husinthewei/PMTPulser/OPics/IMG_4144.JPG

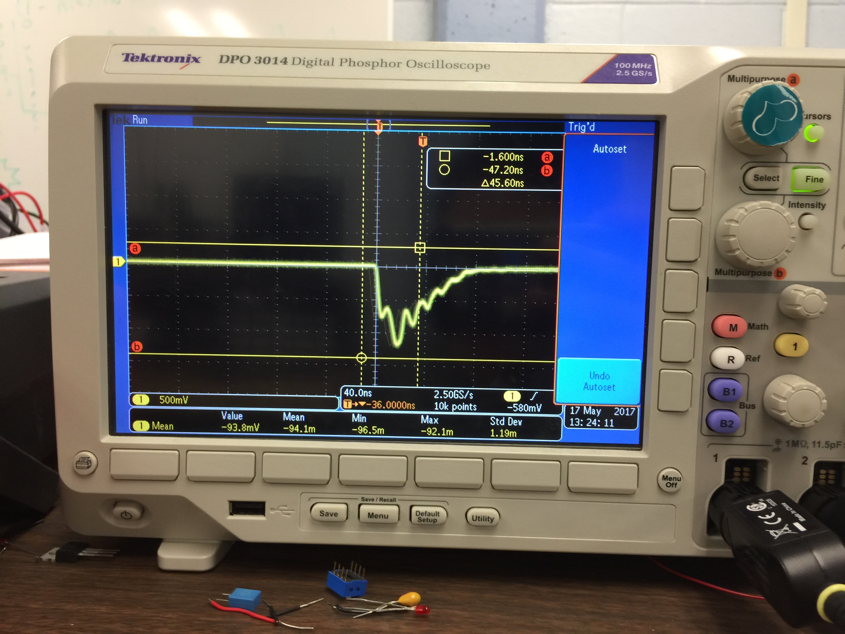
OPics/IMG_4144.JPG
