husinthewei/PMTPulser/OPics/IMG_4136.JPG

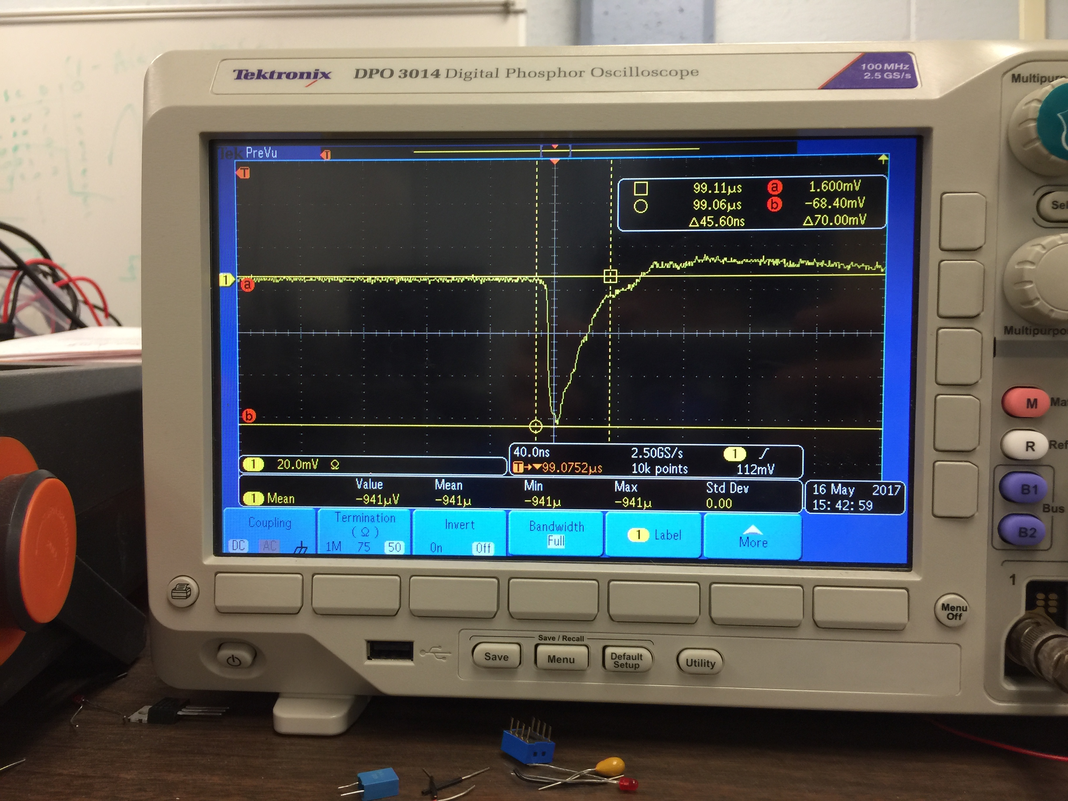
OPics/IMG_4136.JPG
