husinthewei/PMTPulser/README.md

# PMTPulser

A PCB used to emulate photomultiplier tube signals. Pulses have ~500mV amplitude and ~300ns rise time.
