husinthewei/PMTPulser/ltspice/APDAmp/APD_Amp.pptx

## Low Input Impedance APD amp

Mitch Newcomer
Penn
24 June 2013

## APD Amp Schematic

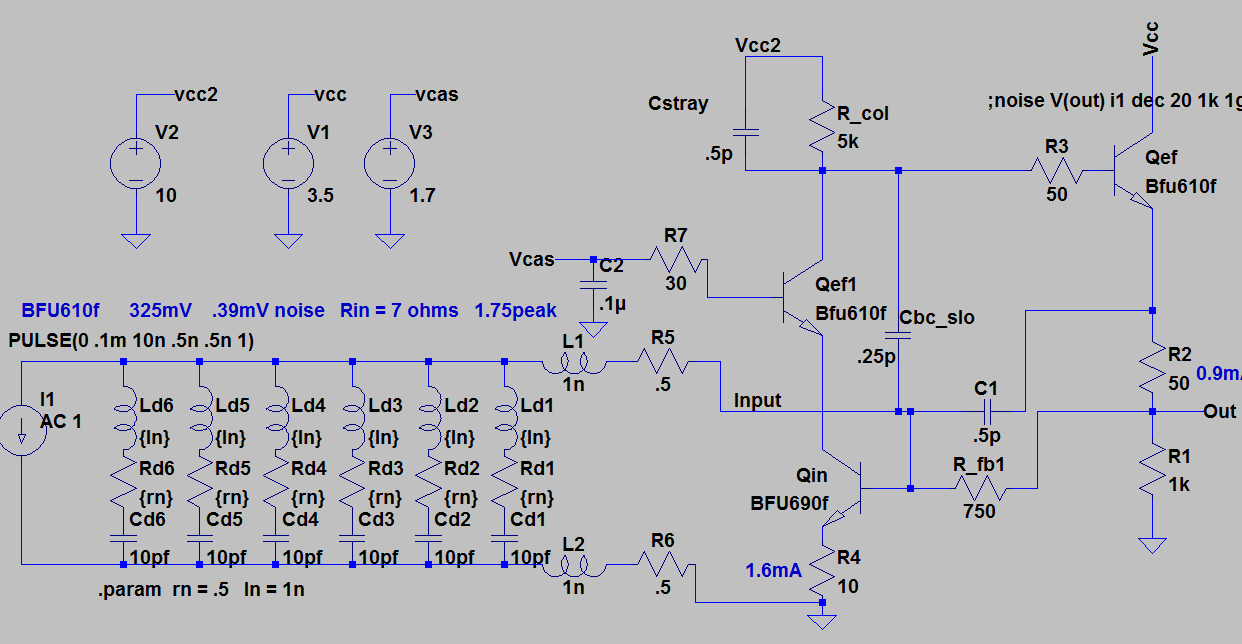
[picture p3: figure]

Detector

## Impulse Response

Input .667mA .5ns Rise, Fall and 1ns duration

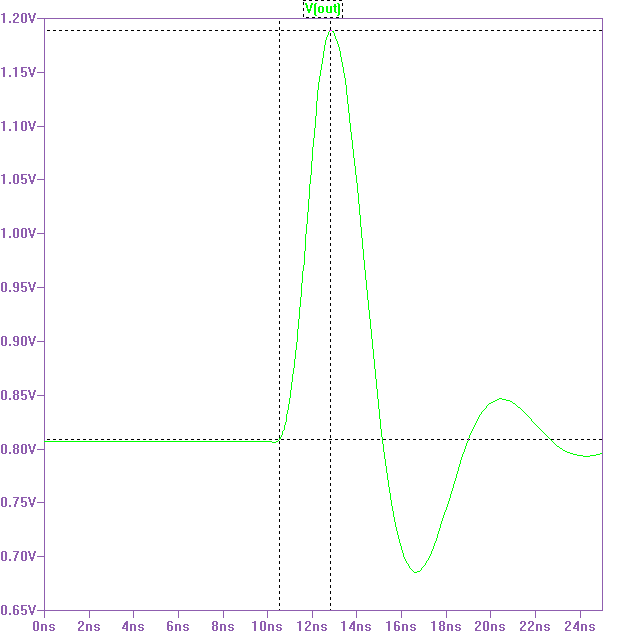
[picture p4: figure]
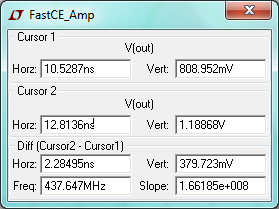
[picture p5: figure]

Overshoot likely a manifestation
Of Impulse input without actual
Detector model. It arises due to
Finite amplifier phase delay.
