husinthewei/PMTPulser/LayoutMarkupsForPlacingComp/pads.PNG

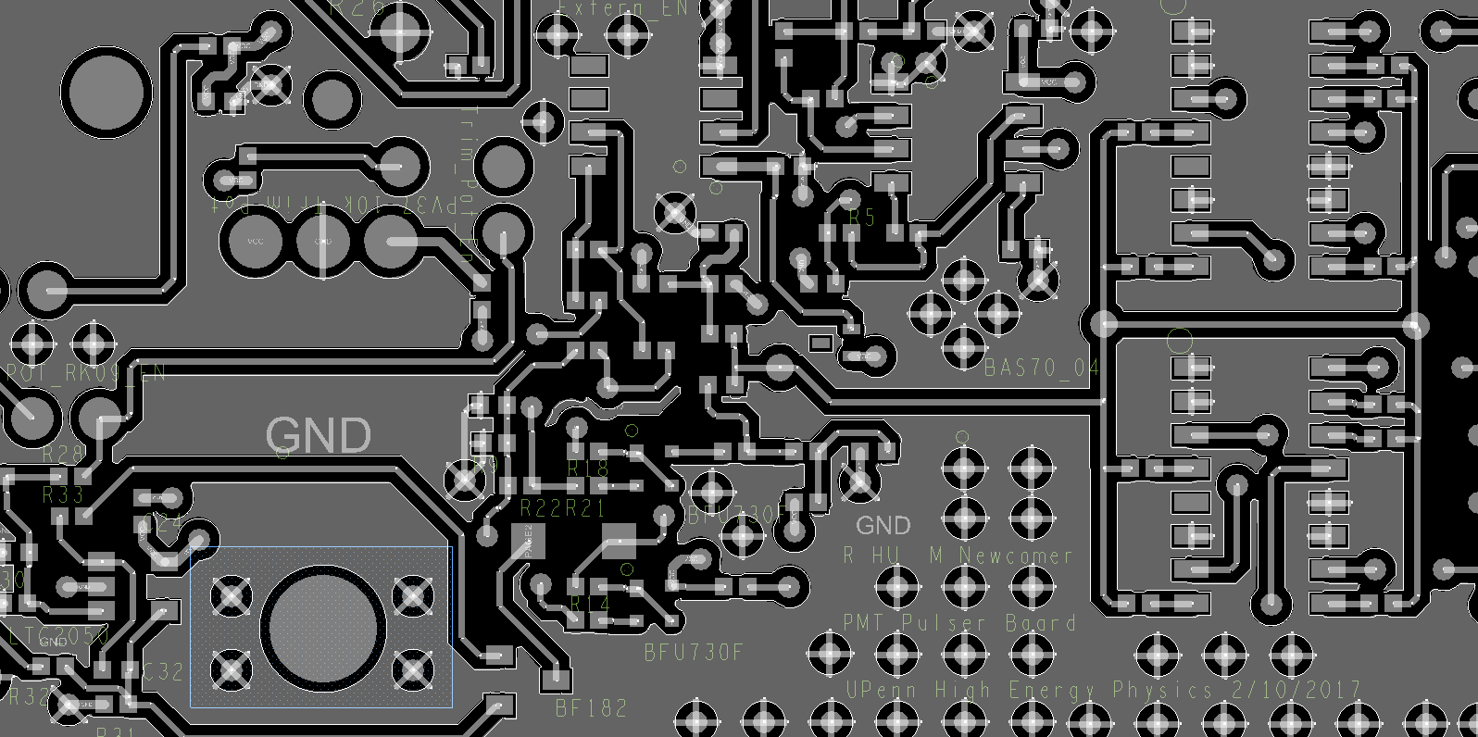
LayoutMarkupsForPlacingComp/pads.PNG
