husinthewei/PMTPulser/OPics/IMG_4111.JPG

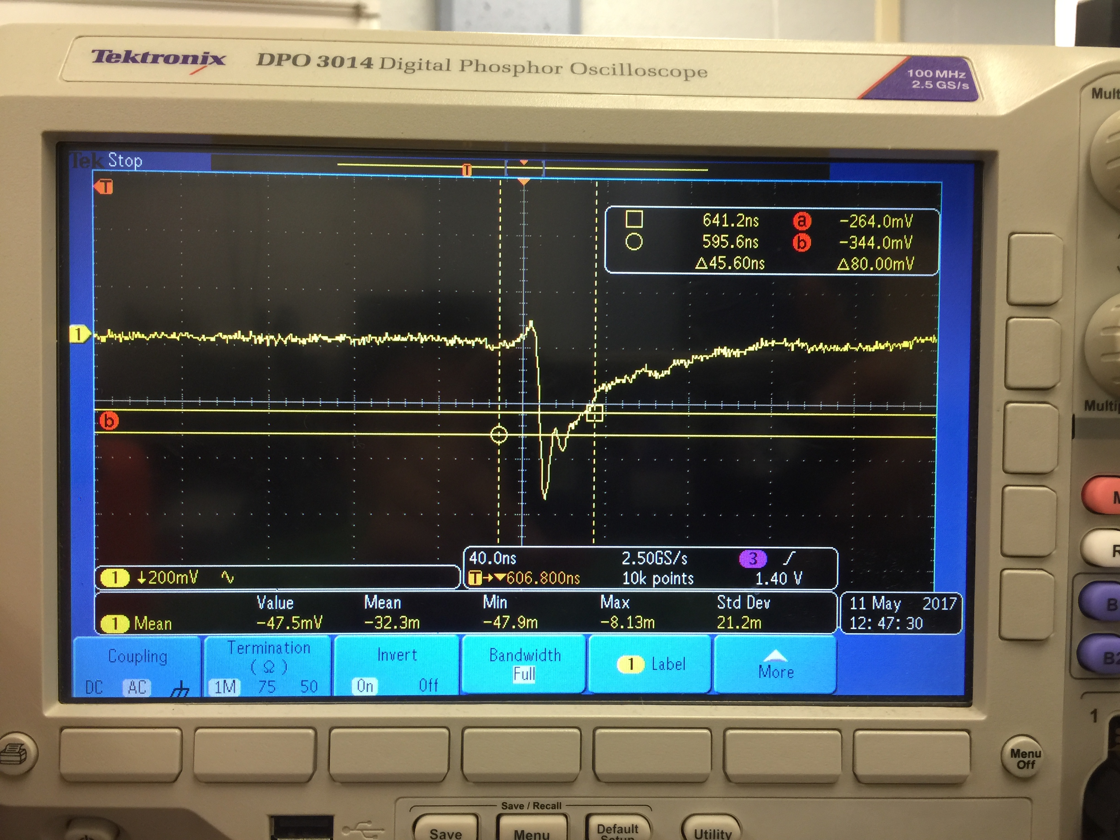
OPics/IMG_4111.JPG
