husinthewei/PMTPulser/OPics/IMG_4112.JPG

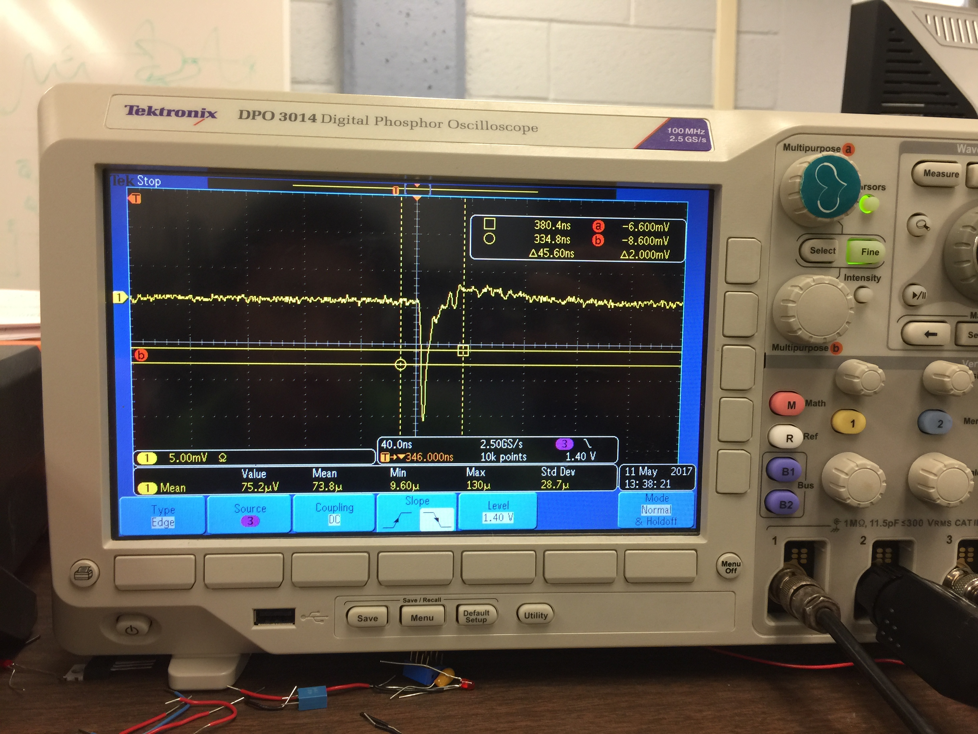
OPics/IMG_4112.JPG
