husinthewei/PMTPulser/OPics/IMG_4115.JPG

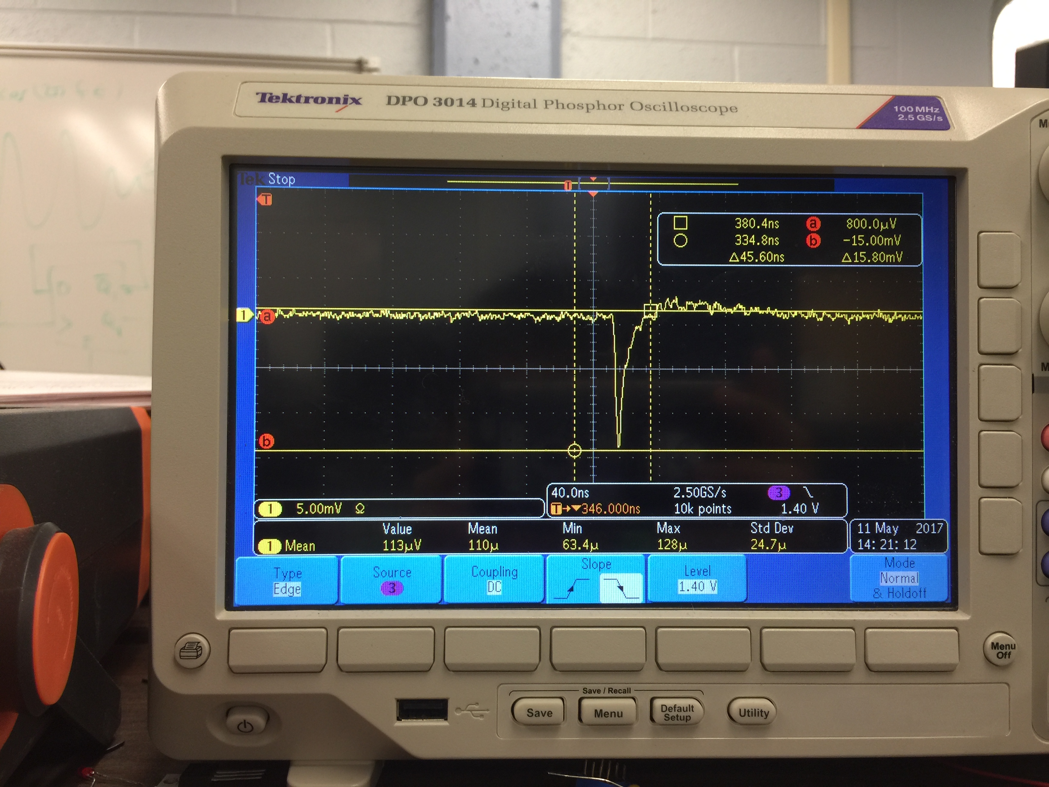
OPics/IMG_4115.JPG
