husinthewei/PMTPulser/OPics/IMG_4120.JPG

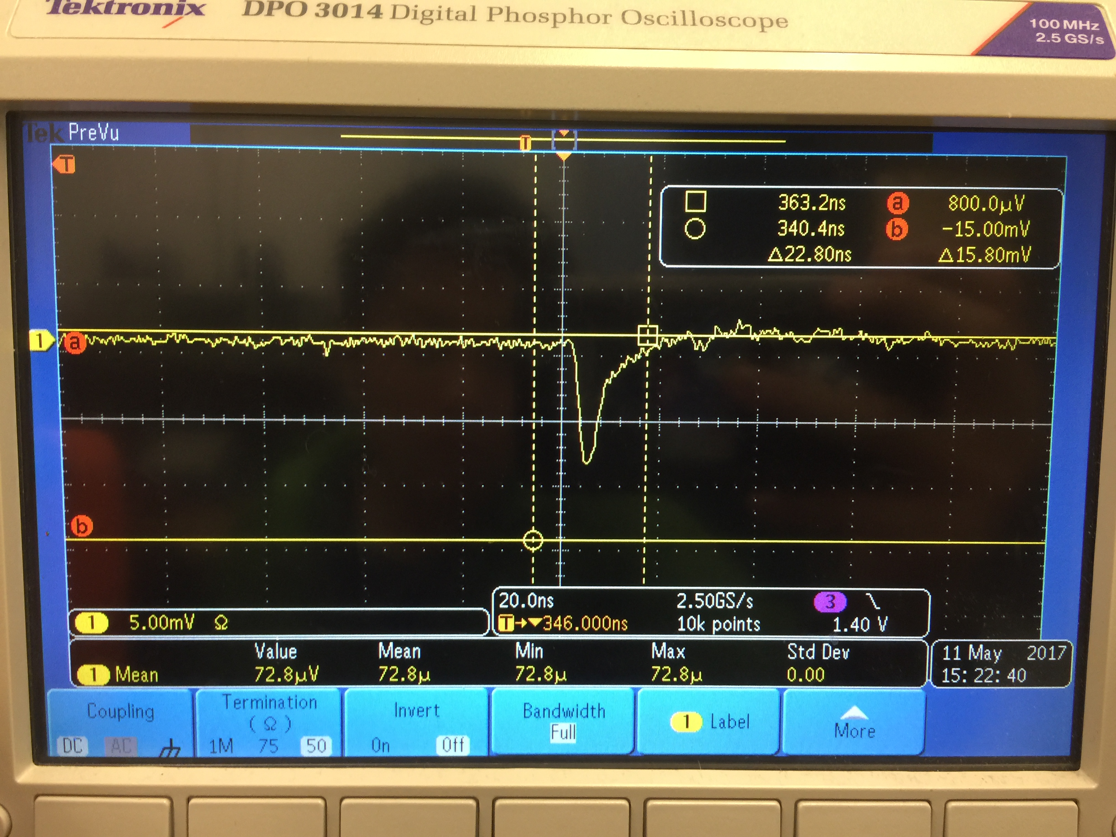
OPics/IMG_4120.JPG
