husinthewei/PMTPulser/OPics/IMG_4121.JPG

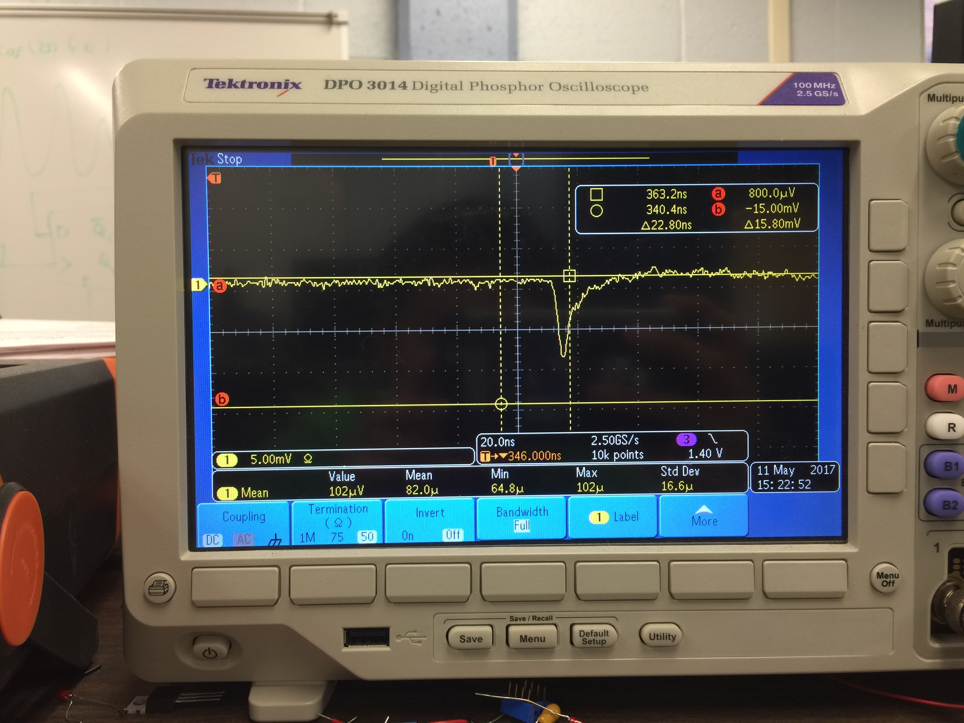
OPics/IMG_4121.JPG
