husinthewei/PMTPulser/OPics/IMG_4132.JPG

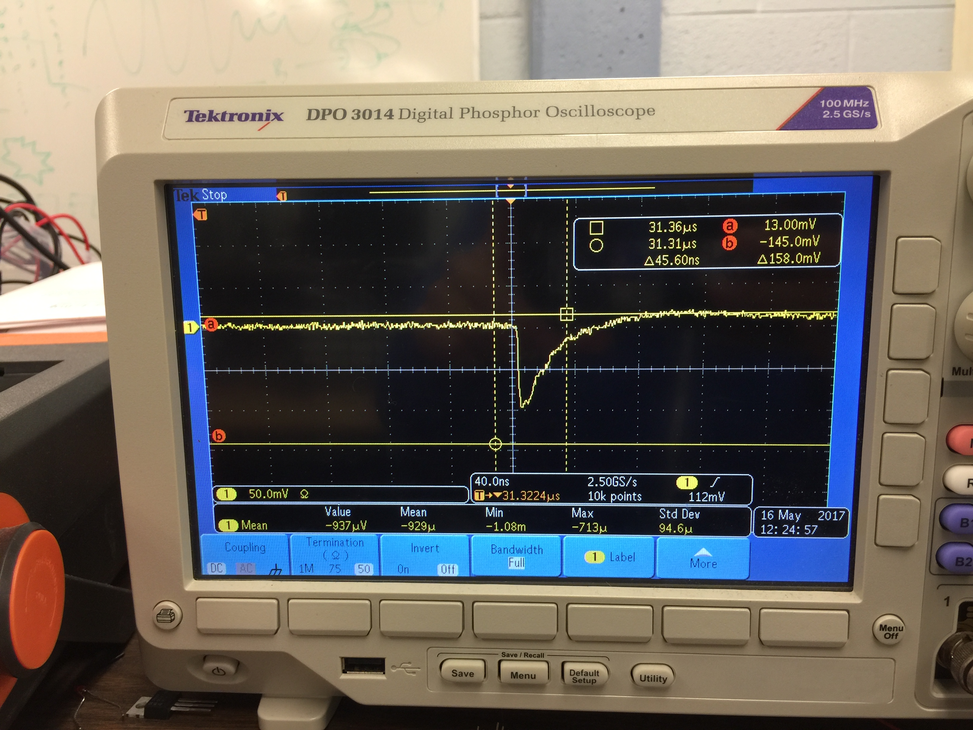
OPics/IMG_4132.JPG
