husinthewei/PMTPulser/OPics/IMG_4142.JPG

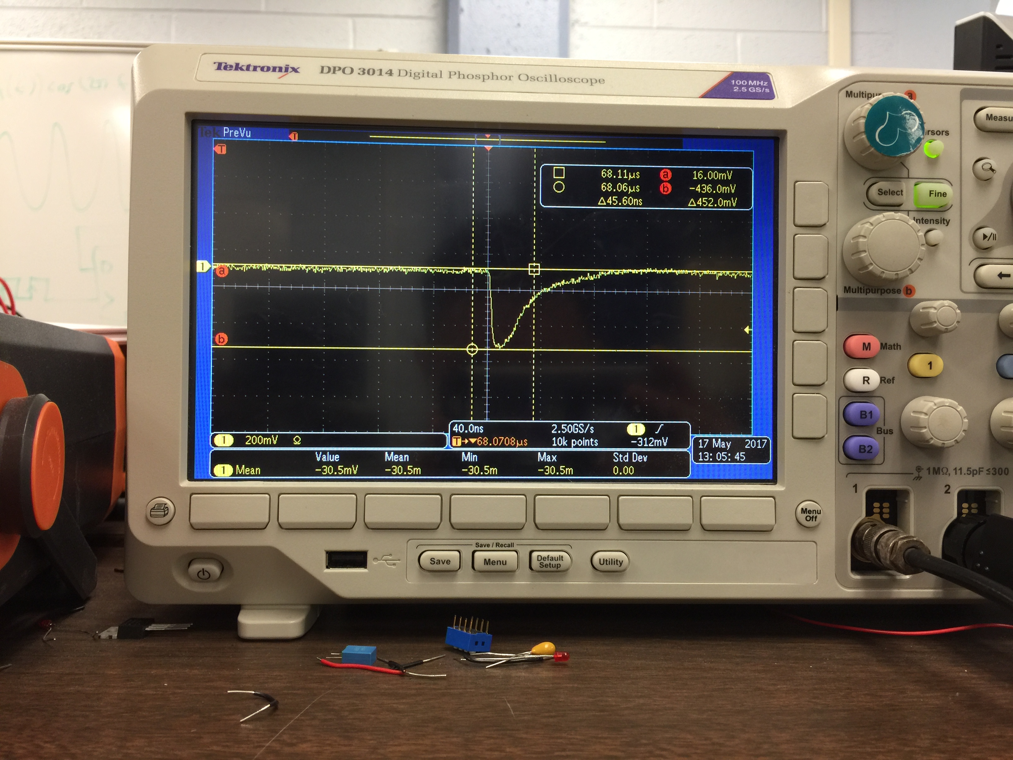
OPics/IMG_4142.JPG
