husinthewei/PMTPulser/OPics/IMG_4143.JPG

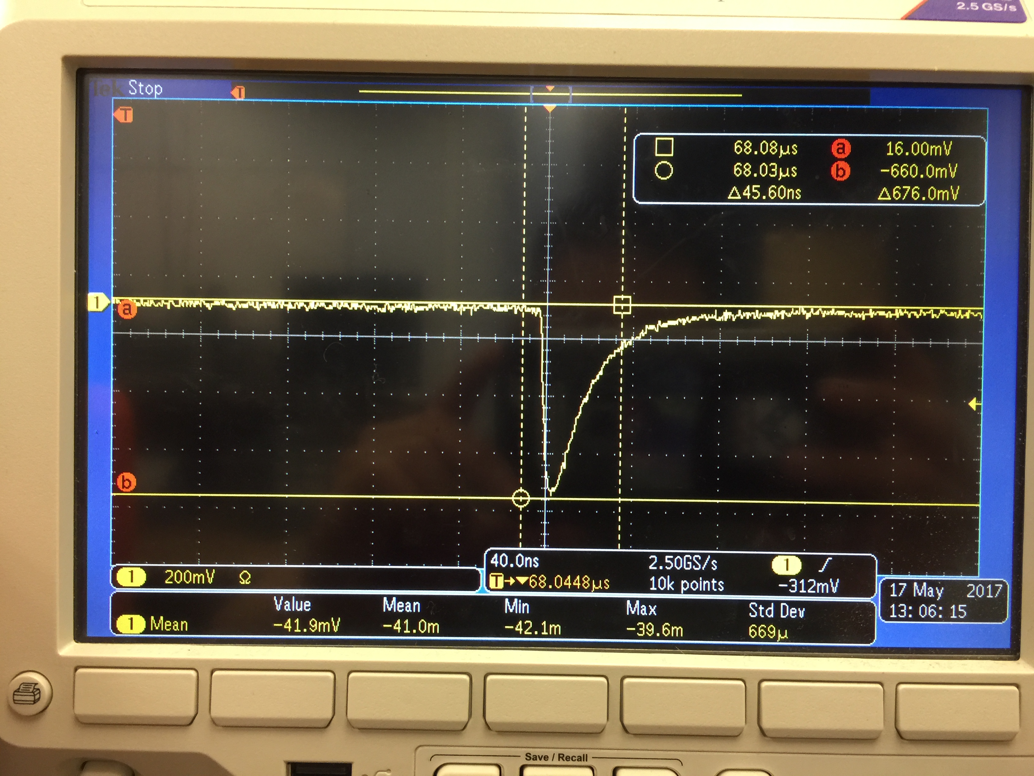
OPics/IMG_4143.JPG
