husinthewei/PMTPulser/LayoutMarkupsForPlacingComp/BoxingComponents.xlsx

Boxed? | SYM_NAME | COMP_DEVICE_TYPE | COMP_VALUE | COMP_TOL | COMP_CLASS | QUANTITY | REFDES
 | C0402 | CSMD0402-0.33UF,10%,0402,25V | 0.33UF |  | DISCRETE | 1 | C1
 | C0402 | CSMD0402-2.2NF,10%,0402,25V | 2.2NF |  | DISCRETE | 1 | C2
 | C0402 | CSMD0402-0.1UF,10%,0402,25V | 0.1UF |  | DISCRETE | 16 | C3;C8;C9;C11;C12;C13;C14;C15;C16;C17;C18;C19;C20;C22;C23;C24
 | C0402 | CSMD0402-10NF,10%,0402,25V | 10NF |  | DISCRETE | 1 | C4
 | C0402 | CSMD0402-40PF,10%,0402,25V | 40PF |  | DISCRETE | 2 | C5;C7
 | C0402 | CSMD0402-1.0NF,10%,0402,25V | 1.0NF |  | DISCRETE | 1 | C6
 | C0402 | CSMD0402-2PF,10%,0402,25V | 2PF |  | DISCRETE | 1 | C10
 | C0402 | CSMD0402-100PF,10%,0402,25V | 100PF |  | DISCRETE | 1 | C21
 | CONN2 | CONN2 |  |  | IC | 30 | J1;J2;J3;J4;J5;J6;J7;J8;J9;J10;J11;J12;J13;J14;J15;J16;J17;J18;J19;J20;J21;J22;J23;J24;J25;J26;J27;J28;J29;J30
 | HSR3 | CONN3 |  |  | IC | 1 | U3
 | MOUNTHOLE_4P5MM | MOUNTHOLE_4P5MM |  |  | IO | 4 | U11;U13;U14;U15
 | R0402 | RSMD0402-50,5%,0402 | 50 |  | DISCRETE | 2 | R1;R23
 | R0402 | RSMD0402-1.5K,5%,0402 | 1.5K |  | DISCRETE | 1 | R2
 | R0402 | RSMD0402-750,5%,0402 | 750 |  | DISCRETE | 1 | R3
 | R0402 | RSMD0402-250,5%,0402 | 250 |  | DISCRETE | 1 | R4
 | R0402 | RSMD0402-20K,5%,0402 | 20K |  | DISCRETE | 1 | R5
 | R0402 | RSMD0402-4K,5%,0402 | 4K |  | DISCRETE | 1 | R6
 | R0402 | RSMD0402-150,5%,0402 | 150 |  | DISCRETE | 1 | R7
 | R0402 | RSMD0402-1K,5%,0402 | 1.0K |  | DISCRETE | 18 | R8;R11;R20;R22;R25;R27;R28;R30;R40;R41;R42;R43;R44;R45;R46;R47;R48;R49
 | R0402 | RSMD0402-20,5%,0402 | 20 |  | DISCRETE | 3 | R9;R14;R18
 | R0402 | RSMD0402-100,5%,0402 | 100 |  | DISCRETE | 2 | R10;R16
 | R0402 | RSMD0402-200,5%,0402 | 200 |  | DISCRETE | 2 | R12;R21
 | R0402 | RSMD0402-3,5%,0402 | 3 |  | DISCRETE | 1 | R13
 | R0402 | RSMD0402-80,5%,0402 | 80 |  | DISCRETE | 1 | R15
 | R0402 | RSMD0402-1,5%,0402 | 1 |  | DISCRETE | 1 | R17
 | R0402 | RSMD0402-3.9K,5%,0402 | 3.9K |  | DISCRETE | 1 | R19
 | R0402 | RSMD0402-10K,5%,0402 | 10K |  | DISCRETE | 2 | R29;R32
 | R0402 | RSMD0402-33,5%,0402 | 33 |  | DISCRETE | 1 | R31
 | R0402 | RSMD0402-111,5%,0402 | 111 |  | DISCRETE | 1 | R33
 | R0402 | RSMD0402-100,5%,0402A | 100 |  | DISCRETE | 10 | R34;R35;R36;R37;R38;R39;R50;R51;R52;R53
 | R1206 | LSMD1206-20UH,10%,1206 | 20UH |  | DISCRETE | 1 | L1
 | RESADJ | TRIMPOT |  |  | DISCRETE | 1 | R26
 | RK09L | RK09L-BASE |  |  | IC | 1 | U6
 | SOIC16 | HFA3128B96 |  |  | IC | 2 | U9;U10
 | SOIC8 | LMC555 |  |  | IC | 1 | U1
 | SOIC8 | ADN4661 |  |  | IC | 1 | U2
 | SOT23 | BFR182 |  |  | IC | 1 | U8
 | SOT343 | BFU730F |  |  | IC | 2 | U4;U5
 | SOT523 | BAV99T |  |  | IC | 1 | U12
 | TO220ABH | 7806_L |  |  | IC | 1 | Q1
 | TSOT23-5 | LTC2050 |  |  | IC | 1 | U7
