husinthewei/PMTPulser/worklib/simplepulser/physical/PMTPulserGerbersBiggerHoles/PMTPulser_Manufacturer_instructions.docx

PMTPulser board Manufacturer’s Instructions

University of Pennsylvania – Physics Dept and Radiology Dept

BOARD NAME: PMTPulser

DATE: Feb 10th, 2017

CONTACTS:

Bill Ashmanskas: ashmansk@hep.upenn.edu

(215) 746-8210

Mike Reilly: mbreilly@hep.upenn.edu

(215) 898-6831

Ranwei Hu: rhu@seas.upenn.edu

(215) 840-2765

MANUFACTURING NOTES

1. This is a 4 layer board

Layer order:

1. TOP

2. GND

3. VCC

4. BOTTOM

4. BOARD THICKNESS: as proposed by manufacturer. We suggest 60 mils or greater.

6. FINISH: Immersion Gold.

7. COPPER THICKNESSES:

GND: 1 oz.

Other layers at manufacturer’s discretion.

8. All holes are plated through unless otherwise noted.
