husinthewei/PMTPulser/SelfContained_Pulser_Build_Sche.pdf

## HFA3128 comes in arrays of 5 transistors each

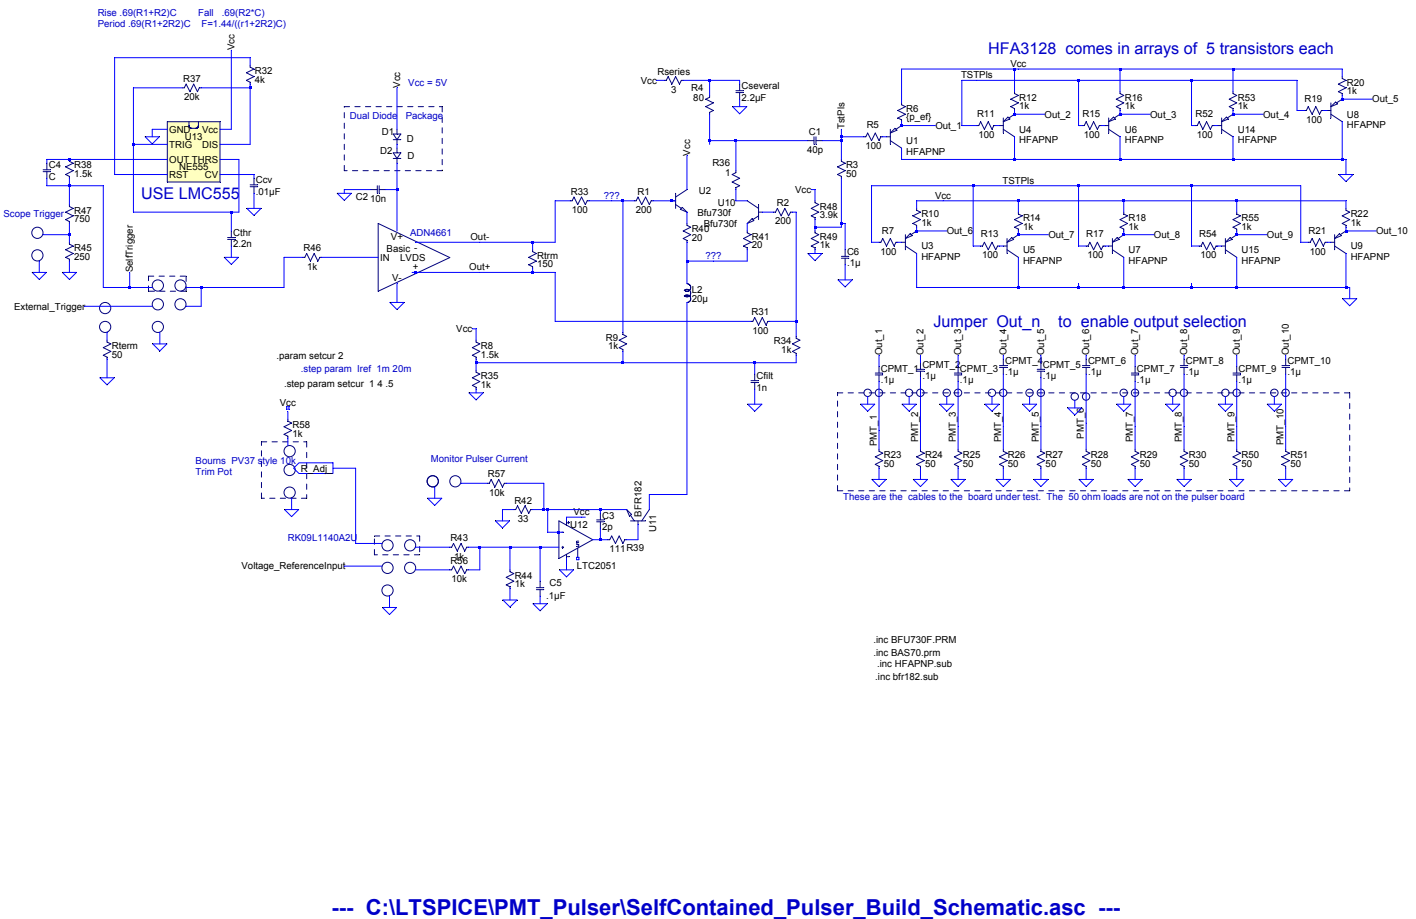
[picture p15: page 1]

Jumper Out_n to enable output selection

These are the cables to the board under test. The 50 ohm loads are not on the pulser board
