husinthewei/PMTPulser/LayoutMarkupsForPlacingComp/topCL.pdf

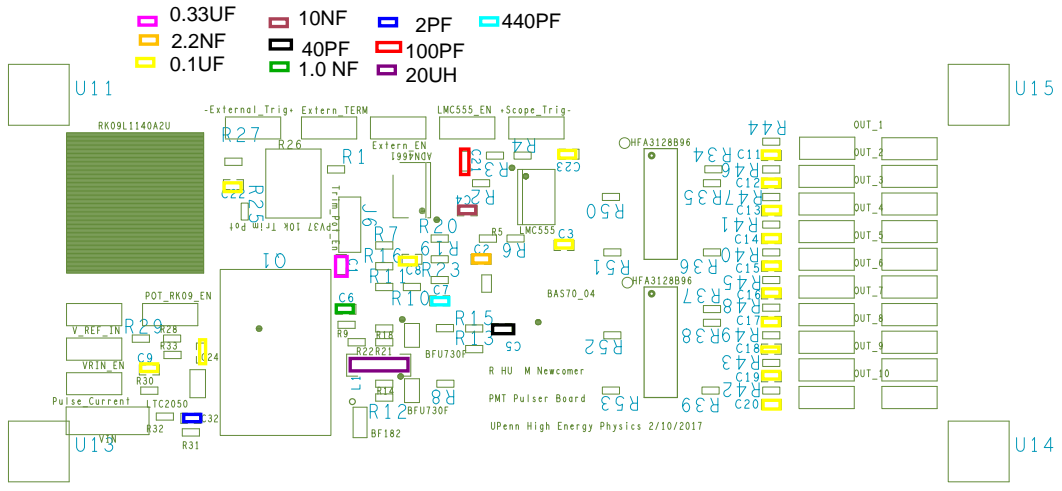
[picture p16: page 1]
