husinthewei/PMTPulser/LayoutMarkupsForPlacingComp/topR.pdf

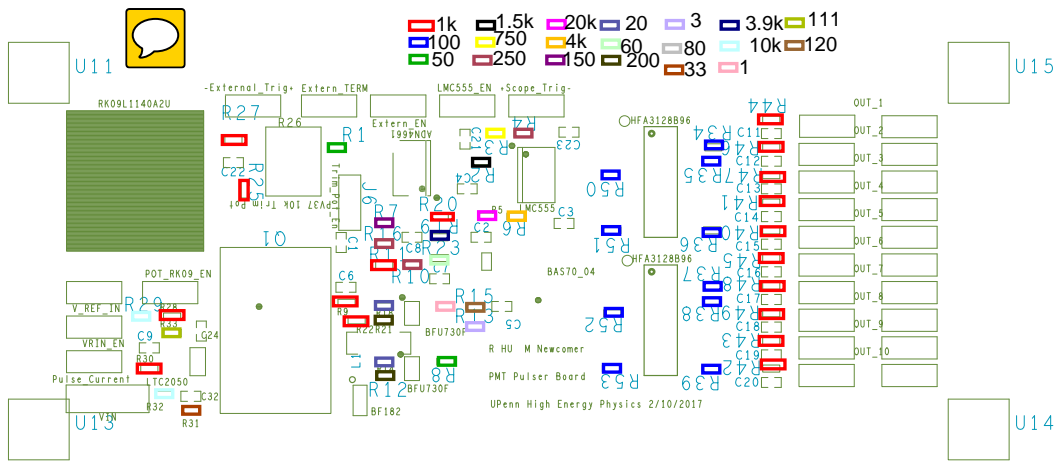
[picture p17: page 1]
