husinthewei/PMTPulser/LayoutMarkupsForPlacingComp/OLDtopR.pdf

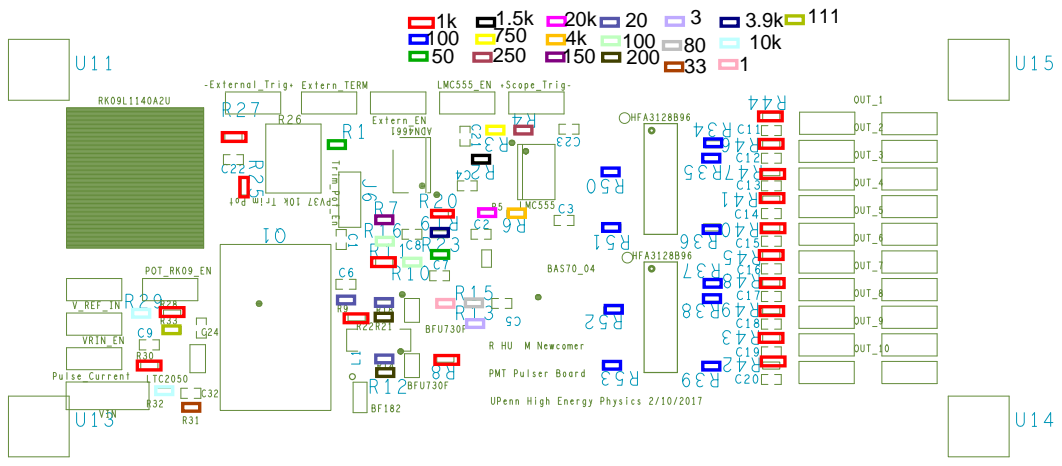
[picture p18: page 1]
