husinthewei/PMTPulser/LayoutMarkupsForPlacingComp/top.pdf

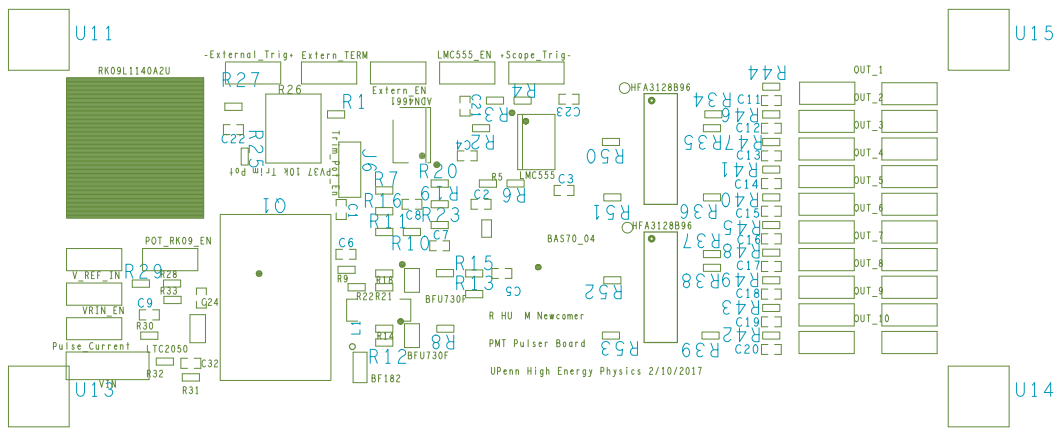
[picture p19: page 1]
