husinthewei/PMTPulser/ltspice/SelfContained_Pulser_Build_Schematic.asc

C1: cap; 40p
C2: cap; 10n
C3: cap; 2p
C4: cap; 100p
C5: cap; .1µF
C6: cap; .1µ
Ccv: cap; .01µF
Cfilt: cap; 1n
CPMT_1: cap; .1µ
CPMT_2: cap; .1µ
CPMT_3: cap; .1µ
CPMT_4: cap; .1µ
CPMT_5: cap; .1µ
CPMT_6: cap; .1µ
CPMT_7: cap; .1µ
CPMT_8: cap; .1µ
CPMT_9: cap; .1µ
CPMT_10: cap; .1µ
Cseveral: cap; 2.2µF
Cthr: cap; 2.2n
D1: diode
D2: diode
L2: ind; 20µ
R1: res; 200
R2: res; 200
R3: res; 50
R4: res; 80
R5: res; 100
R6: res; 1k
R7: res; 100
R8: res; 1.5k
R9: res; 1k
R10: res; 1k
R11: res; 100
R12: res; 1k
R13: res; 100
R14: res; 1k
R15: res; 100
R16: res; 1k
R17: res; 100
R18: res; 1k
R19: res; 100
R20: res; 1k
R21: res; 100
R22: res; 1k
R23: res; 50
R24: res; 50
R25: res; 50
R26: res; 50
R27: res; 50
R28: res; 50
R29: res; 50
R30: res; 50
R31: res; 100
R32: res; 4k
R33: res; 100
R34: res; 1k
R35: res; 1k
R36: res; 1
R37: res; 20k
R38: res; 1.5k
R39: res; 111
R40: res; 20
R41: res; 20
R42: res; 33
R43: res; 1k
R44: res; 1k
R45: res; 250
R46: res; 1k
R47: res; 750
R48: res; 3.9k
R49: res; 1k
R50: res; 50
R51: res; 50
R52: res; 100
R53: res; 1k
R54: res; 100
R55: res; 1k
R56: res; 10k
R57: res; 10k
R58: res; 1k
Rseries: res; 3
Rterm: res; 50
Rtrm: res; 150
U1: xpnp; HFAPNP
U2: xnpn; Bfu730f
U3: xpnp; HFAPNP
U4: xpnp; HFAPNP
U5: xpnp; HFAPNP
U6: xpnp; HFAPNP
U7: xpnp; HFAPNP
U8: xpnp; HFAPNP
U9: xpnp; HFAPNP
U10: xnpn; Bfu730f
U11: xnpn; BFR182
U12: LTC2051
U13: NE555
U14: xpnp; HFAPNP
U15: xpnp; HFAPNP
V1: voltage; 5
X1: LVDS_drive
Named nets: Out_2, Out_7, Out_3, Out_5, Out_8, Out_10, Out_6, Out_1, TstPls, TSTPls, Vcc, 0, Out_4, PMT_1, PMT_2, PMT_3, PMT_4, PMT_5, PMT_6, PMT_7, PMT_8, Out-, Out+, SelfTrigger, External_Trigger, Out_9, PMT_9, PMT_10, Voltage_ReferenceInput, R_Adj_
.inc BFU730F.PRM
.inc BAS70.prm
.inc HFAPNP.sub
Jumper  Out_n    to  enable output selection
HFA3128  comes in arrays of  5 transistors each
.step param  Iref  1m 20m
.step param setcur  1 4 .5
These are the  cables to the  board under test.  The  50 ohm loads are not on the pulser board
.inc bfr182.sub
.param setcur 2
Vcc = 5V
Dual Diode   Package
Rise .69(R1+R2)C        Fall   .69(R2*C)
Period .69(R1+2R2)C    F=1.44/((r1+2R2)C)
USE LMC555
Scope Trigger
ADN4661
Monitor Pulser Current
RK09L1140A2U
Bourns  PV37 style 10k 
Trim Pot
.tran 10p 200n
