husinthewei/PMTPulser/ltspice/SelfContained_Pulser_Divider.asc

C1: cap; 100p
C3: cap; 2p
C4: cap; {Cs}
CPMT_1: cap; .1µ
CPMT_2: cap; .1µ
CPMT_3: cap; .1µ
CPMT_4: cap; .1µ
CPMT_5: cap; .1µ
CPMT_6: cap; .1µ
CPMT_7: cap; .1µ
CPMT_8: cap; .1µ
Cs1: cap; {Cs}
Cs2: cap; {Cs}
Cs3: cap; {Cs}
Cs4: cap; {Cs}
Cseveral: cap; 2.2µF
L1: ind; 1n
L2: ind; 20µ
L3: ind; 1n
L4: ind; 20n
L5: ind; 20n
R1: res; 200
R2: res; 200
R3: res; 200
R4: res; 250
R5: res; 100
R6: res; {p_ef}
R7: res; 100
R8: res; 1k
R9: res; 1k
R10: res; {p_ef}
R11: res; 100
R12: res; {p_ef}
R13: res; 100
R14: res; {p_ef}
R15: res; 100
R16: res; {p_ef}
R17: res; 100
R18: res; {p_ef}
R19: res; 100
R20: res; {p_ef}
R21: res; 100
R22: res; {p_ef}
R23: res; 50
R24: res; 50
R25: res; 50
R26: res; 50
R27: res; 50
R28: res; 50
R29: res; 50
R30: res; 50
R31: res; 100
R32: res; 750
R33: res; 100
R34: res; 1k
R36: res; 1
R39: res; 111
R40: res; 20
R41: res; 20
R42: res; 33
R43: res; 1.8k
R44: res; 200
Rseries: res; 3
Rtrm: res; 150
U1: xpnp; HFAPNP
U2: xnpn; Bfu730f
U3: xpnp; HFAPNP
U4: xpnp; HFAPNP
U5: xpnp; HFAPNP
U6: xpnp; HFAPNP
U7: xpnp; HFAPNP
U8: xpnp; HFAPNP
U9: xpnp; HFAPNP
U10: xnpn; Bfu730f
U11: xnpn; BFR182
U12: LTC2051
V1: voltage; PULSE(0 3 5n 15n 15n 100n)
V2: voltage; 5
V5: voltage; {setcur}
Voffs: voltage; 1
X1: LVDS_drive
Named nets: 0, Vcc, Out_2, Out_6, Out_3, Out_4, Out_7, Out_8, Out_5, Out_1, TstPls, TSTPls, PMT_1, PMT_2, PMT_3, PMT_4, PMT_5, PMT_6, PMT_7, PMT_8
.inc BFU730F.PRM
.tran 0 30n 0
.inc BAS70.prm
.param     Cs =1p
.inc HFAPNP.sub
Jumper  Out_n    to  enable output selection
HFA3128  comes in arrays of  5 transistors each
CSn   = Cstray n
.step param  Iref  1m 20m
.param p_ef = 250
.step param setcur  1 4 .5
These are the  cables to the  board under test.  The  50 ohm loads are not on the pulser board
.inc bfr182.sub
.param setcur 2
