husinthewei/PMTPulser/ltspice/LVDS_drive.asc

B1: bi; I=-2*{iset}*(V(a)>V(b))
C1: cap; 1p
I2: current; {iset}
R1: res; 10k
R2: res; 10k
R3: res; 2k
R4: res; 10k
R5: res; 2k
R6: res; 2k
R7: res; 10k
R8: res; 10k
V2: voltage; 1.2
Named nets: IN, V-, V+, A, B, +, -, 0
.param iset = 3mA
Output
