husinthewei/PMTPulser/ltspice/Simple_Pulser.asc

C1: cap; 40p
C2: cap; 20p
CPMT_1: cap; .1µ
CPMT_2: cap; .1µ
CPMT_3: cap; .1µ
CPMT_4: cap; .1µ
CPMT_5: cap; .1µ
CPMT_6: cap; .1µ
CPMT_7: cap; .1µ
CPMT_8: cap; .1µ
Cs1: cap; {Cs}
Cs2: cap; {Cs}
Cs3: cap; {Cs}
Cs4: cap; {Cs}
Cseveral: cap; 2.2µF
L1: ind; 100n
R1: res; 50
R2: res; 300
R3: res; 50
R4: res; 50
R5: res; 200
R6: res; 1k
R7: res; 200
R8: res; 500
R9: res; 80
R10: res; 1k
R11: res; 200
R12: res; 1k
R13: res; 200
R14: res; 1k
R15: res; 200
R16: res; 1k
R17: res; 200
R18: res; 1k
R19: res; 200
R20: res; 1k
R21: res; 200
R22: res; 1k
R23: res; 50
R24: res; 50
R25: res; 50
R26: res; 50
R27: res; 50
R28: res; 50
R29: res; 50
R30: res; 50
R31: res; 50
Rseries: res; 3
U1: xpnp; HFAPNP
U2: xnpn; Bfu760f
U3: xpnp; HFAPNP
U4: xpnp; HFAPNP
U5: xpnp; HFAPNP
U6: xpnp; HFAPNP
U7: xpnp; HFAPNP
U8: xpnp; HFAPNP
U9: xpnp; HFAPNP
V1: voltage; PULSE(0 3.3 10n 3n 3n 100n)
V2: voltage; 3.3
V_DtoA: voltage; {D2Aset}
Voffs: voltage; 1
Named nets: 0, Vcc, Out_2, Out_6, Out_3, Out_4, Out_7, Out_8, Out_5, Out_1, TstPls, TSTPls, N_DtoA, PMT_1, PMT_2, PMT_3, PMT_4, PMT_5, PMT_6, PMT_7, PMT_8
.inc BFU760F.PRM
.tran 0 30n 0
.inc BAS70.prm
.param D2Aset = 3      Cs = 2p
.inc HFAPNP.sub
Jumper  Outputs of  PNP transistors In or Out
HFA3128  comes in arrays of  5 transistors each
CSn   = Cstray n
