husinthewei/PMTPulser/ltspice/APDAmp/FastCE_Amp.asc

C1: cap; .35p
C2: cap; .1µ
C3: cap; .1µ
C4: cap; .1µ
C5: cap; 1µ
Cbc_slo: cap; .5p
Cload: cap; 10p
Cmiller: cap; 1p
Cstray: cap; .5p
D1: diode; 1N914
D2: diode; 1N914
I1: current; PULSE(0 .667m 10n .5n .5n 1n); AC 1
L1: ind; 10n
L2: ind; 10n
LStray: ind; 5n
Qcas: xnpn; BFU710f
Qef1: xnpn; Bfu730f
Qef: xnpn; Bfu710f
Qin: xnpn; BFU690f
R1: res; 510
R2: res; 240
R3: res; 100
R4: res; 20
R5: res; 9.1k
R6: res; 50
R7: res; 100
R9: res; 750
R10: res; 100
R11: res; 33
R12: res; 100
R13: res; 10
R14: res; 5
R15: res; 33
R_col: res; 5k
R_fb1: res; 700
V1: voltage; 3.5
V2: voltage; 10
Named nets: Vcc, 0, Input, vcc, vcc2, Vcc2, Vcas, Out
.inc BFU730F.PRM
.inc BFU710F.PRM
.param  rn = .5   ln = 1n
.tran 0 25n 0 .5n
.inc BFU610F.PRM
.inc BFU690F.PRM
;noise V(out) i1 dec 20 1k 1g
BFU610f      325mV    .39mV noise   Rin = 7 ohms   1.75peak
1.6mA
0.9mA
Low stray
Low stray
FastAmp With Drive
.inc BFU760F.PRM
