husinthewei/PMTPulser/(commit log)

2016-12-17 Started project
    [expand.cfg]
2016-12-21 Started creating parts
    [cases.cfg, lmc555.psm]
2016-12-22 Started making parts
    [lmc555.psm, page1.csv, pmtpulser.brd, tsot23-5.psm]
2016-12-28 Added basic components to schematic
    [page1.csv]
2016-12-28 Halfway done schematic
    [page1.csv]
2016-12-30 Fixed errors and made new parts
    [expand.cfg, page1.csv, pmtpulser_0_0.brd, rk09l.psm]
2017-01-04 Finished making parts
    [expand.cfg, page1.csv, page2.csv]
2017-01-05 Replaced res and caps
    [expand.cfg, page1.csv]
2017-01-05 Finished schematic
    [expand.cfg, page1.csv, page2.csv, page3.csv]
2017-01-05 Checked schematic
    [page3.csv]
2017-01-05 Attempting to fix exporting errors
    [expand.cfg, page1.csv]
2017-01-05 Started layout
    [expand.cfg, page1.csv, pmtpulser.brd]
2017-01-08 Placed components
    [expand.cfg, pmtpulser.brd]
2017-01-09 Began routing
    [pmtpulser.brd]
2017-01-09 Finished routing
    [pmtpulser.brd]
2017-01-09 Designed silkscreen
    [art_param.txt, pmtpulser.brd]
2017-01-10 Checked through
    [page2.csv, pmtpulser.brd]
2017-01-10 Added Mitch's suggestions to schematic
    [page1.csv, page2.csv, pmtpulser.brd, sot523.psm]
2017-01-12 Completed Mitch's suggestions
    [expand.cfg, page1.csv, pmtpulser.brd]
2017-01-13 Fixing issues
    [expand.cfg, pmtpulser.brd]
2017-01-13 Followed Manny's suggestions
    [expand.cfg, page1.csv, page2.csv, page3.csv, pmtpulser.brd]
2017-01-19 Went over some things with Mitch
    Need to move the TestPulse traces up.
    [page1.csv, page2.csv, page3.csv, pmtpulser.brd]
2017-01-20 Moved testpulse to top layer
    [page3.csv, pmtpulser.brd]
2017-01-27 Shortened VCC plane
    [pmtpulser.brd]
2017-01-27 Finishing touches
    [page1.csv, pmtpulser.brd]
2017-02-03 Reduced capacitance and made board better overall
    [pmtpulser.brd]
2017-02-09 Added many Vias
    Need to find the DRC errors and then submit
    [expand.cfg, pmtpulser.brd]
2017-02-10 Created gerbers
    [nc_param.txt, pmtpulser.brd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]
2017-02-10 Made vias bigger
    [nc_param.txt, pmtpulser.brd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]
2017-03-17 Marked up layout pdf for resistors
2017-03-21 Finished filling BOM
    [BoxingComponents.xlsx]
2017-05-10 Added notes from debugging
    [BoxingComponents.xlsx]
